capsoid/hab/README.md

# HAB - High Altitude Ballon Project

The repository contains documentation on building and launching high altitude balloon.

## Content

- **general-ideas.md** - the file lists general ideas and directions on the project;
- **flight-model** - equations and calculations on balloon motion.
