capsoid/hab/general-ideas.md

# General Ideas

Following items need to be worked out:
- **flight-train** - the balloon itself, helium (storage and filling systems), recovery system, cord and payload;
- **payload** - payload content, design and functionality;
- **launch** - procedure, conditions, date and legal considerations.

## Balloons
- **14"** - [RR-14P/XX](http://shar.by/catalog/rr-14p-04-pastel-oranzhevyj) with diameter 0.36m and weight 0.0043kg (0.16BYR);
- **27"** - [G220/XX](http://shar.by/catalog/g220-14-pastel-chyornyj) with diameter 0.70m and weight 0.01955kg (2.00BYR);
- **45"** - [P350/XX](http://shar.by/catalog/p-350-002-olimpijskij-pastel-ekstra) with diameter 1.15m and weight 0.0445kg (4.00BYR).

## Helium
- **tank** - [0.01m<sup>3</sup>](http://shar.by/catalog/ballon-gelievyj-10l) able to store about 1.4m<sup>3</sup> of helium at STP (150BYR);
- **gas** - [0.01m<sup>3</sup>](http://shar.by/catalog/gelij-10-litrov) 99.8% about 1.4m<sup>3</sup> at STP (140BYR);
- **pressure regulator** - [БГО-50-4ВШ](https://shop.oliver.by/cat3/gazovaya-svarka/kopiya-reduktor-aczetilenovyij-s-manometrom-kitaj.html) (65.00BYR);
- **stand** - [transportable](http://donballon.by/product/telezhka-podstavka-dlya-ballona-10l/) for 0.01m<sup>3</sup> tank (162,16BYR) also there is [cheaper option](http://donballon.by/product/podstavka-pod-ballon-10-litrov/) but it's absent for now;
- **high-pressure hose** - later we may need the hose to fill big balloons (can be ordered for right connectors and length).

## Pressure-size Balloon Experiment
The dependency of balloon diameter on pressure difference is required to complete the set of equations for balloon dynamic. The experiment requires pressure sensor. The existing Bosh sensor with [the instructions](http://faradaysclub.com/?p=1325) can be easily used. Additionally, an air hose for aquarium like [this one](https://garfield.by/catalog/akvariumistika/aeratsiya/komplektuyushchie/boyu-rt-shlang.html).

## Payload Cooling Experiment
The payload needs to stay on-line at temperatures -50 - -60 &deg;C. To achieve the temperature range on the ground we can use dry ice from [Bar Portal](http://shop.barportal.by/siropi-pyure-i-kokteylnie-komponenti/ice/dry-ice/).

## Smoke Test

Quick flight test for two balloons:
- size 0.37m lift 22g (calculated lift for 15 &deg;C and 101.325 kPa - 18.9g; vol 0.0265m<sup>3</sup>);
- size 0.455m lift 44g (calculated lift for 15 &deg;C and 101.325 kPa - 43.0g; vol 0.0493m<sup>3</sup>).

Karatsevich'es device test:

The device is represented by a piece of nichrome wire with resistance about 0.7 - 1&#x3a9;.
- power source of 3.5V and current 4.3A the device burns latex within 3 - 4s;
- batteries (2 AA) 3.1 - 3.2V (drops to 2.5V) and current 2.8A burns latex within similar interval.

## Other HAB Links
- HAB BOM: https://community.balloonchallenge.org/t/hab-supplies-list/677 (Radar Reflector is interesting)
- HAB electronics: https://www.sparkfun.com/tutorials/185 (1W 900MHz transmitter)
- HAB eqiupment enclosure and heater: https://www.sparkfun.com/tutorials/188
- HAB 29MHz 50mW transmitter (200miles distance) https://www.swharden.com/wp/2010-07-14-high-altitude-balloon-transmitter/
- HAB Flight Planner: http://astra-planner.soton.ac.uk/
- Flight Predictor: http://predict.habhub.org
