capsoid/hab/hardware/Friis formula.xlsx

 | Friis Formula
TX power | Pt | 0.01 | W
RX antenna gain | Gr | 1 | times
TX antenna gain | Gt | 5 | times
speed of light | c | 299972458 | m/s
Frequency | f | 434000000 | Hz
Distance | d | 38900 | m
RX power | Pr | 9.996776795e-14 | W | -100.0014 | dBm
 | Antenna gain "times-to-dBi"
Antenna gain: | G | 5 | times | 6.989700043 | dBi
 | Power "Watts-to-dBm"
Power | P | 9.9968e-14 | W | -100.00139 | dBm
