capsoid/hab/flight-model/model.pdf

# Flight Model

Vasili V

November 22, 2018

## 1 Lift

The buoyant force on a balloon of diameter d with density of content ρin and environmental density ρout:

Fb = (ρout − ρin)g

πd³
6
, | (1)

where content is Helium with density (at STP):

ρin = 0.1786 [kg m⁻³
]. | (2)

The environment is standard atmosphere taken from [1] at zero altitude:

ρout = 1.225 [kg m⁻³
]. | (3)

under following conditions:

p = 1.013 25 × 10⁵

[kg m⁻³
].
T = 288.15 | [K].

(4)

Under the conditions Helium density is:

ρin = 0.1786 ·

1.013 25 × 10⁵
1 × 10⁵

·

273.15
288.15

= 0.1715 [kg m⁻³
]. | (5)

Let’s simplify equation (1): Fb = k0d

3
, | (6)

where k0 is:

k0 =

π
6
- 9.81 · (1.225 − 0.1715) = 5.411. [N m⁻³
] | (7)

For example balloons with diameters 0.36, 0.70 and 1.15 m get following lifts:

Fs = 5.411 · 0.36³ = 0.2525[N] = 25.74[gf];

Fm = 5.411 · 0.70³ = 1.856[N] = 189.3[gf];

Fb = 5.411 · 1.15³ = 8.230[N] = 839.2[gf].

(8)

1

These balloons have following volumes:

Vs = 24.43 [L];
Vm = 179.6 [L];
Vb = 796.3 [L],

(9)

which is approximately 1
57 ,

1/7 and 2
3

of 10 L tank.

## References

[1] NOAA, NASA, USAF, US. Standard Atmosphere, 1976

2
