capsoid/hab/experiments/size-pressure/README.md

# Size-Pressure Experiment

The directory contains data on size-pressure dependency measurements. The size and pressure measured both for balloon inflation and deflation. 18" and 36" balloons have been used in the experiment.

# Schema

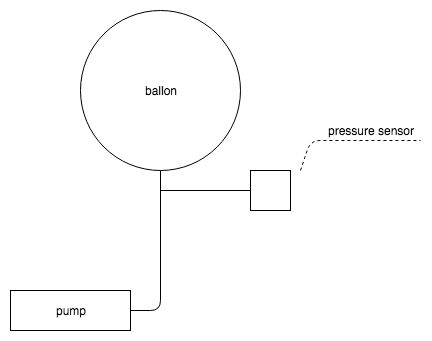
[picture p1: experiments/size-pressure/s-p.png]
Size-Pressure Experiment Schema


BMP180 has been used as pressure sensor.
=======
# Size-Pressure Experiment

The directory contains data on size-pressure dependency measurements. The size and pressure measured both for balloon inflation and deflation. A 18" balloon has been used in the experiment.

# Schema

Size-Pressure Experiment Schema

BMP180 has been used as pressure sensor.
