capsoid/hab/hardware/stratospheric_balloon/stratospheric_balloon.pdf

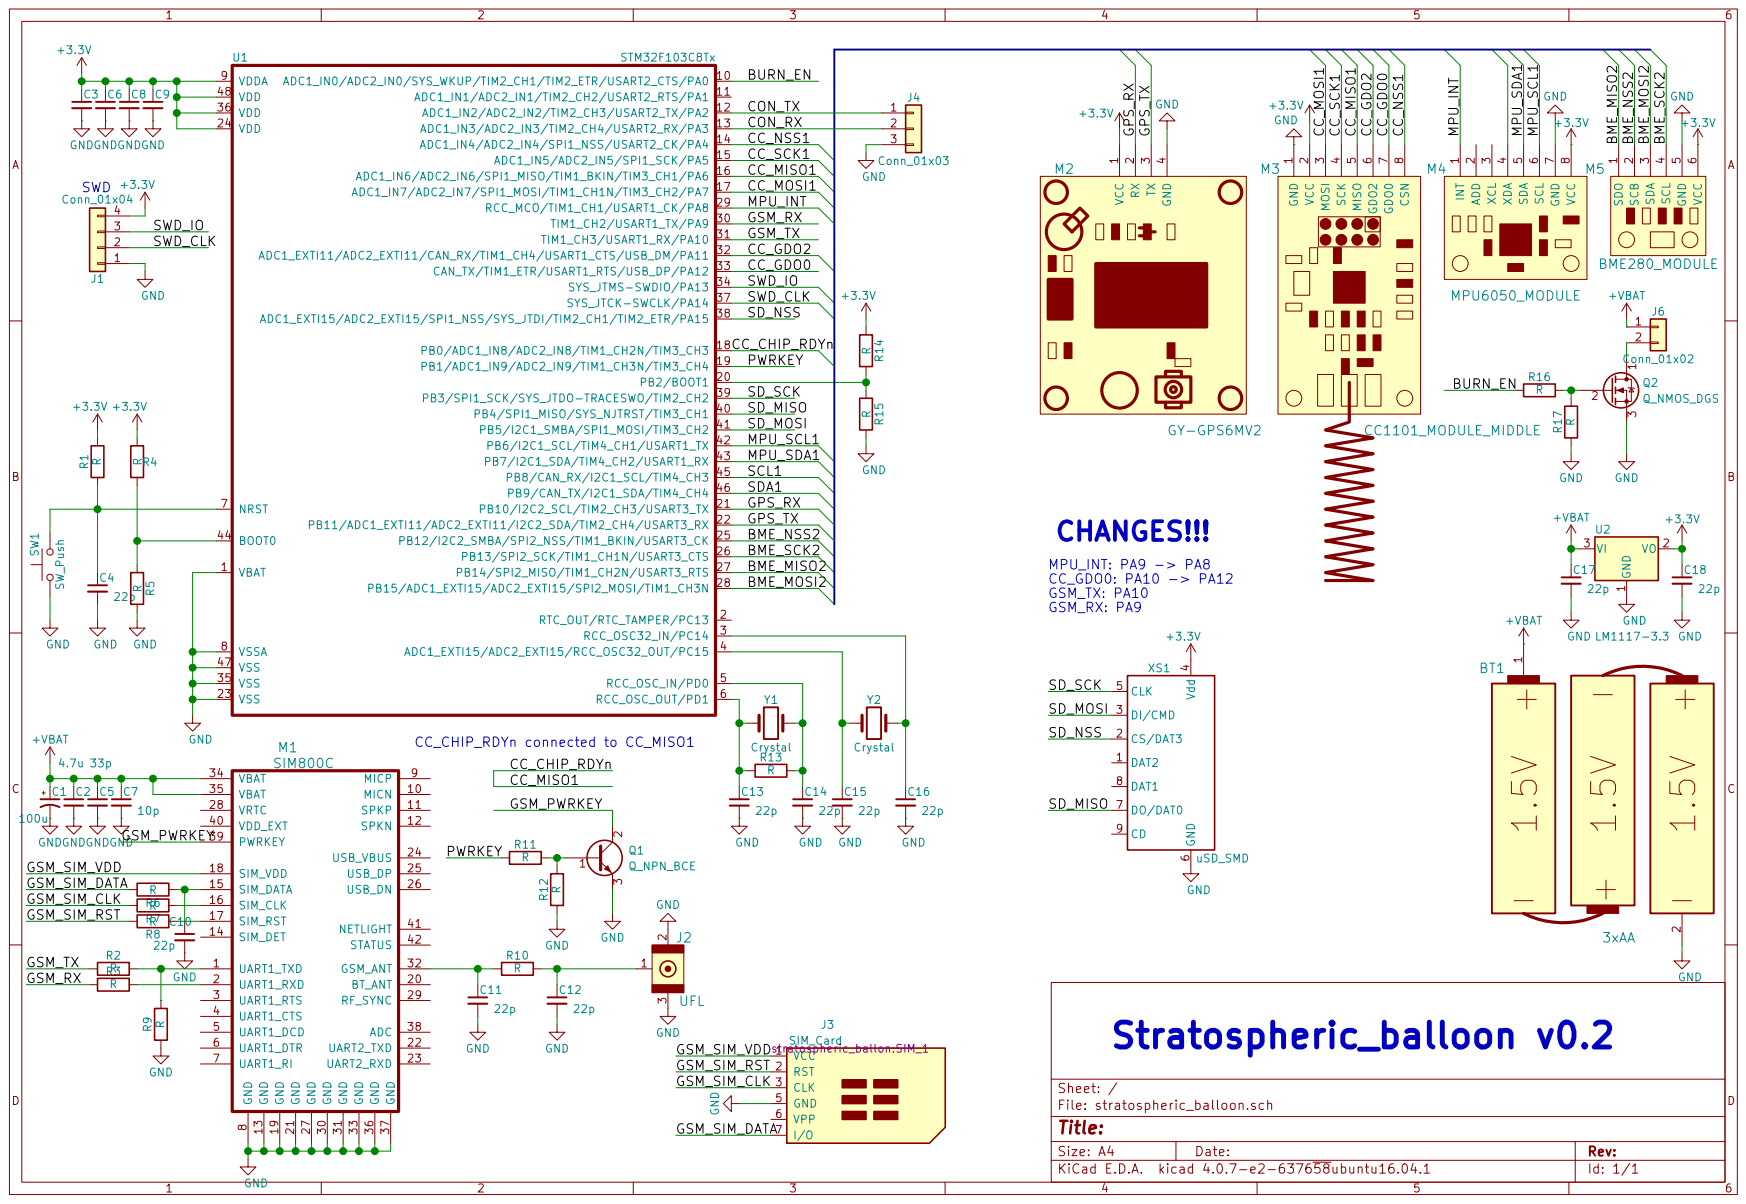
[picture p2: page 1]
