capsoid/hab/hardware/stratospheric_balloon/stratospheric_balloon.kicad_pcb

## KiCad design hardware/stratospheric_balloon/stratospheric_balloon.kicad_pcb (2019-07-24)

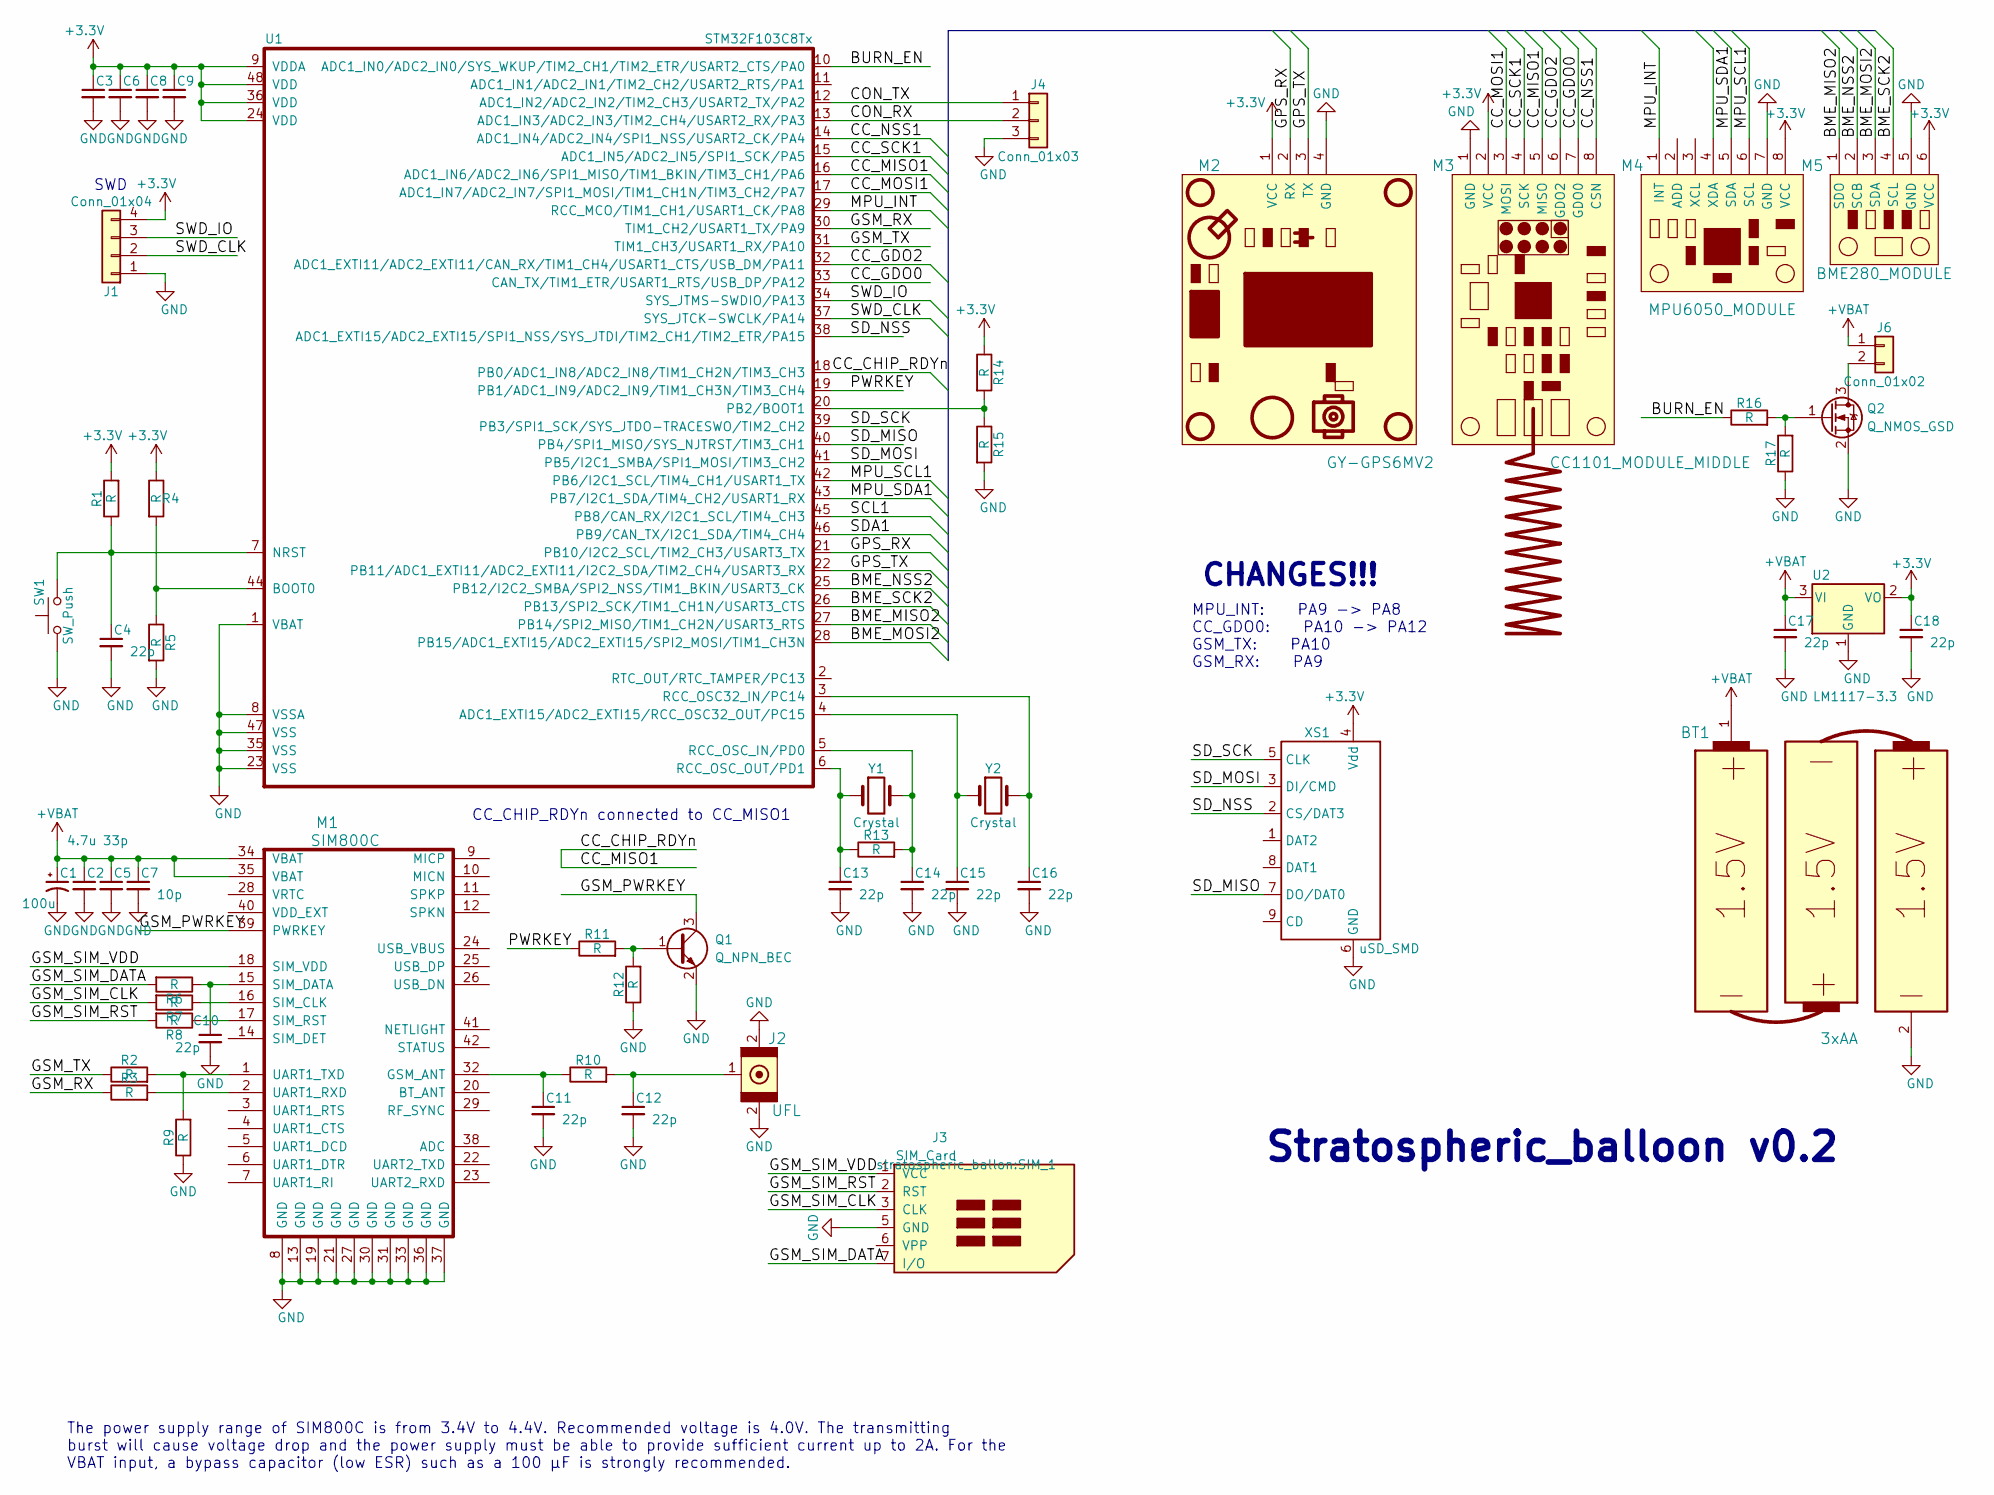
[picture p3: schematic stratospheric_balloon.sch]

Parts:
BT1: 3xAA
C1: 100u; CP_Tantalum_Case-C_EIA-6032-28_Reflow
C2: 4.7u; C_0603
C3, C6, C8, C9: C_0603
C4, C10, C11, C12, C13, C14, C15, C16, C17, C18: 22p; C_0603
C5: 33p; C_0603
C7: 10p; C_0603
J1: Conn_01x04; PinHeader_1x04_P2.54mm_Vertical
J2: UFL; U.FL_Molex_MCRF_73412-0110_Vertical
J3: SIM_Card; SIM_1
J4: Conn_01x03; PinHeader_1x03_P2.54mm_Vertical
J6: Conn_01x02; TerminalBlock_bornier-2_P5.08mm
M1: SIM800C; SIMCom_SIM800C
M2: GY-GPS6MV2; GY-GPS6MV2_MODULE
M3: CC1101_MODULE_MIDDLE
M4: MPU6050_MODULE
M5: BME280_MODULE
Q1: Q_NPN_BEC; SOT-23
Q2: Q_NMOS_GSD; SOT-23
R1, R2, R3, R4, R5, R6, R7, R8, R9, R10, R11, R12, R13, R14, R15, R16, R17: R; R_0603
SW1: SW_Push
U1: STM32F103C8Tx; LQFP-48_7x7mm_Pitch0.5mm
U2: LM1117-3.3; SOT-223
XS1: uSD_SMD; Conn_uSDcard
Y1: Crystal; Crystal_HC49-4H_Vertical
Y2: Crystal; Crystal_Round_d2.0mm_Vertical

Connections:
+3V3: C3.1, C6.1, C8.1, C9.1, C18.1, J1.4, M2.1 (VCC), M3.2 (VCC), M4.8 (VCC), M5.6 (VCC), R1.2, R4.1, R14.1, U1.9 (VDDA), U1.24 (VDD), U1.36 (VDD), U1.48 (VDD), U2.2 (VO), XS1.4 (Vdd)
/BME_MISO2: M5.1 (SDO), U1.27 (PB14/SPI2_MISO/TIM1_CH2N/USART3_RTS)
/BME_MOSI2: M5.3 (SDA), U1.28 (PB15/ADC1_EXTI15/ADC2_EXTI15/SPI2_MOSI/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)
/BME_NSS2: M5.2 (SCB), U1.25 (PB12/I2C2_SMBA/SPI2_NSS/TIM1_BKIN/USART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)
/BME_SCK2: M5.4 (SCL), U1.26 (PB13/SPI2_SCK/TIM1_CH1N/USART3_CTS)
/BURN_EN: R16.1, U1.10 (ADC1_IN0/ADC2_IN0/SYS_WKUP/TIM2_CH1/TIM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)
/CC_CHIP_RDYn: M3.5 (MISO), U1.16 (ADC1_IN6/ADC2_IN6/SPI1_MISO/TIM1_BKIN/T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), U1.18 (PB0/ADC1_IN8/ADC2_IN8/TIM1_CH2N/TIM3_CH3)
/CC_GDO0: M3.7 (GDO0), U1.33 (CAN_TX/TIM1_ETR/USART1_RTS/USB_DP/PA12)
/CC_GDO2: M3.6 (GDO2), U1.32 (ADC1_EXTI11/ADC2_EXTI11/CAN_RX/TIM1_CH4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)
/CC_MOSI1: M3.3 (MOSI), U1.17 (ADC1_IN7/ADC2_IN7/SPI1_MOSI/TIM1_CH1N/T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)
/CC_NSS1: M3.8 (CSN), U1.14 (ADC1_IN4/ADC2_IN4/SPI1_NSS/USART2_CK/PA4)
/CC_SCK1: M3.4 (SCK), U1.15 (ADC1_IN5/ADC2_IN5/SPI1_SCK/PA5)
/CON_RX: J4.2, U1.13 (ADC1_IN3/ADC2_IN3/TIM2_CH4/USART2_RX/PA3)
/CON_TX: J4.1, U1.12 (ADC1_IN2/ADC2_IN2/TIM2_CH3/USART2_TX/PA2)
/GPS_RX: M2.2 (RX), U1.21 (PB10/I2C2_SCL/TIM2_CH3/USART3_TX)
/GPS_TX: M2.3 (TX), U1.22 (PB11/ADC1_EXTI11/ADC2_EXTI11/I2C2_SDA/T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)
/GSM_PWRKEY: M1.39 (PWRKEY), Q1.3 (C)
/GSM_RX: R3.1, U1.30 (TIM1_CH2/USART1_TX/PA9)
/GSM_SIM_CLK: J3.3 (CLK), R7.2
/GSM_SIM_DATA: J3.7 (I/O), R6.2
/GSM_SIM_RST: J3.2 (RST), R8.2
/GSM_SIM_VDD: J3.1 (VCC), M1.18 (SIM_VDD)
/GSM_TX: R2.1, U1.31 (TIM1_CH3/USART1_RX/PA10)
/MPU_INT: M4.1 (INT), U1.29 (RCC_MCO/TIM1_CH1/USART1_CK/PA8)
/MPU_SCL1: M4.6 (SCL), U1.42 (PB6/I2C1_SCL/TIM4_CH1/USART1_TX)
/MPU_SDA1: M4.5 (SDA), U1.43 (PB7/I2C1_SDA/TIM4_CH2/USART1_RX)
/PWRKEY: R11.1, U1.19 (PB1/ADC1_IN9/ADC2_IN9/TIM1_CH3N/TIM3_CH4)
/SD_MISO: U1.40 (PB4/SPI1_MISO/SYS_NJTRST/TIM3_CH1), XS1.7 (DO/DAT0)
/SD_MOSI: U1.41 (PB5/I2C1_SMBA/SPI1_MOSI/TIM3_CH2), XS1.3 (DI/CMD)
/SD_NSS: U1.38 (ADC1_EXTI15/ADC2_EXTI15/SPI1_NSS/SYS_JT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), XS1.2 (CS/DAT3)
/SD_SCK: U1.39 (PB3/SPI1_SCK/SYS_JTDO-TRACESWO/TIM2_CH2), XS1.5 (CLK)
/SWD_CLK: J1.2, U1.37 (SYS_JTCK-SWCLK/PA14)
/SWD_IO: J1.3, U1.34 (SYS_JTMS-SWDIO/PA13)
GND: BT1.2, C1.2, C2.2, C3.2, C4.2, C5.2, C6.2, C7.2, C8.2, C9.2, C10.2, C11.2, C12.2, C13.2, C14.2, C15.2, C16.2, C17.2, C18.2, J1.1, J2.2, J3.5 (GND), J4.3, M1.8 (GND), M1.13 (GND), M1.19 (GND), M1.21 (GND), M1.27 (GND), M1.30 (GND), M1.31 (GND), M1.33 (GND), M1.36 (GND), M1.37 (GND), M2.4 (GND), M3.1 (GND), M4.7 (GND), M5.5 (GND), Q1.2 (E), Q2.2 (S), R5.2, R9.1, R12.1, R15.2, R17.1, SW1.1, U1.1 (VBAT), U1.8 (VSSA), U1.23 (VSS), U1.35 (VSS), U1.47 (VSS), U2.1 (GND), XS1.6 (GND)
unnamed: C4.1, R1.1, SW1.2, U1.7 (NRST)
unnamed: C10.1, M1.15 (SIM_DATA), R6.1
unnamed: C11.1, M1.32 (GSM_ANT), R10.1
unnamed: C12.1, J2.1, R10.2
unnamed: C13.1, R13.1, U1.6 (RCC_OSC_OUT/PD1), Y1.1
unnamed: C14.1, R13.2, U1.5 (RCC_OSC_IN/PD0), Y1.2
unnamed: C15.1, U1.4 (ADC1_EXTI15/ADC2_EXTI15/RCC_OSC32_OUT/P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), Y2.1
unnamed: C16.1, U1.3 (RCC_OSC32_IN/PC14), Y2.2
unnamed: J6.2, Q2.3 (D)
unnamed: M1.1 (UART1_TXD), R2.2, R9.2
unnamed: M1.2 (UART1_RXD), R3.2
unnamed: M1.16 (SIM_CLK), R7.1
unnamed: M1.17 (SIM_RST), R8.1
unnamed: Q1.1 (B), R11.2, R12.2
unnamed: Q2.1 (G), R16.2, R17.2
unnamed: R4.2, R5.1, U1.44 (BOOT0)
unnamed: R14.2, R15.1, U1.20 (PB2/BOOT1)
VBAT: BT1.1, C1.1, C2.1, C5.1, C7.1, C17.1, J6.1, M1.34 (VBAT), M1.35 (VBAT), U2.3 (VI)

Notes on the sheet:
Stratospheric_balloon v0.2
CC_CHIP_RDYn connected to CC_MISO1
The power supply range of SIM800C is from 3.4V to 4.4V. Recommended voltage is 4.0V. The transmitting burst will cause voltage drop and the power supply must be able to provide sufficient current up to 2A. For the VBAT input, a bypass capacitor (low ESR) such as a 100 µF is strongly recommended.
SWD
MPU_INT: PA9 -> PA8 CC_GDO0: PA10 -> PA12 GSM_TX: PA10 GSM_RX: PA9
CHANGES!!!

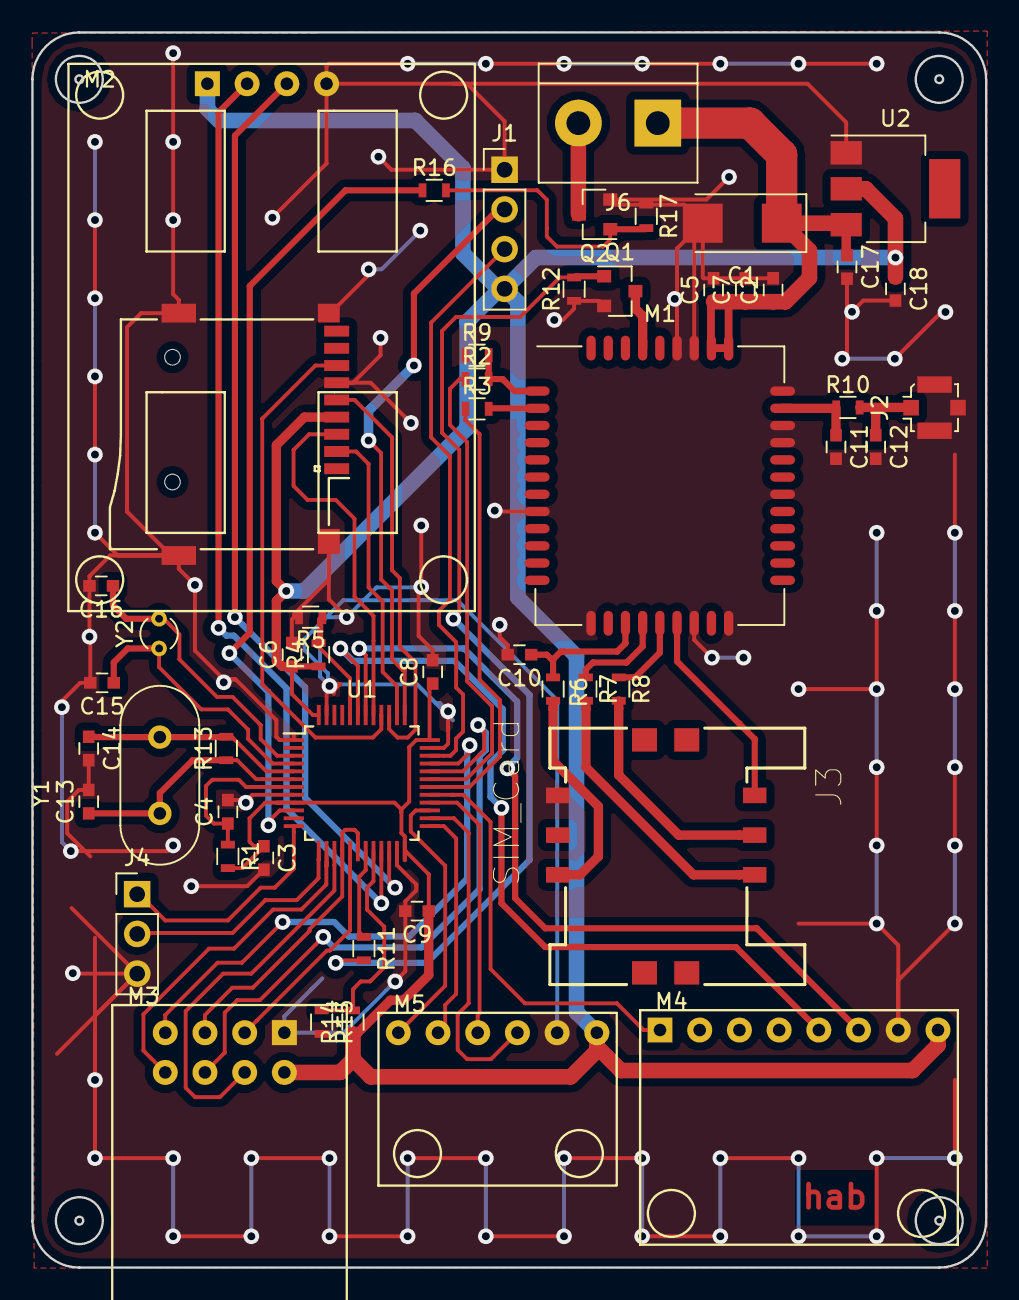
[picture p4: board stratospheric_balloon.kicad_pcb from above]

Board: 2 copper layers, 61.0 x 79.0 mm, 52 parts (0 on the bottom side), 52 nets.
