capsoid/hab/(commit log)

2018-11-22 Add note on pressure-size experiment
2018-12-03 Add zephyr project for stm32 blue pill
2018-12-04 Schematic added
    [stratospheric_balloon.kicad_pcb, stratospheric_balloon.sch]
2018-12-04 Add Friis formula xls
    [Friis formula.xlsx]
2018-12-04 A bit more of SPI
2018-12-09 Add cc1101 code skeleton, not tested, not working
    [cc1101.c, main.c]
2018-12-09 Added first data on size-pressure experiment
    [s-p.csv]
2018-12-09 Add size-pressure experiment schema; Round volume data on the graph
2018-12-09 Scale down size-pressure experiment schema
2018-12-10 Schematic diagram was corrected
    [stratospheric_balloon.sch]
2018-12-11 Account for CHIP_RDYn pin
2018-12-12 Reconfigure to see threads info from shell
2018-12-13 Adjust cc1101 pin connections according to schematics
2018-12-14 Fix spi data format
    [cc1101.c]
2018-12-16 Add results of size-pressure experiment for 36"
    [s-p.csv]
2018-12-19 Add mpu6050 manual reset
    [main.c]
2018-12-20 Fix mpu6050 values displaying
    [main.c]
2018-12-20 Add cc1101 driver implementation from PR
2018-12-20 Crunch in cc1101 driver
2018-12-21 Add DEVICE_INIT and gpios conf
2018-12-21 Fix cc1101 initalization
    Still crashes when RX thread is spawned ...
    [cc1101.c, ieee802154_cc1101.c, ieee802154_cc1101.h, main.c]
2018-12-22 Setup channel and tx power on startup
2018-12-28 Fix gpio interrupts conf
    [ieee802154_cc1101.c, ieee802154_cc1101_rf.h]
2019-03-28 Add mcu and modem schematic components
2019-04-04 Add some components for GSM and MCU
    [stratospheric_balloon.sch]
2019-04-07 Put all components on A4. Do connectians.
    [stratospheric_balloon.sch]
2019-04-07 Add SIM and microsd slots
    [stratospheric_balloon.sch]
2019-04-10 Add footprints for GPS, GSM, BME, MPU
2019-04-20 Add some footprints
2019-04-22 Assign some footprints to sch elements
    [stratospheric_balloon.kicad_pcb, stratospheric_balloon.sch]
2019-04-26 Fix mistakes with footprints. Do layout
    [stratospheric_balloon.kicad_pcb, stratospheric_balloon.sch]
2019-05-01 Add some changes in layout
    [stratospheric_balloon.kicad_pcb]
2019-07-12 Change vias. Add power planes
    [stratospheric_balloon.kicad_pcb]
2019-07-24 Add vias
    [stratospheric_balloon.kicad_pcb]
2019-07-24 Add origin. Add sizes.
    [stratospheric_balloon.kicad_pcb]
2019-08-04 Add some values
    [stratospheric_balloon.sch]
2019-08-13 Add layout
    [stratospheric_balloon.kicad_pcb]
2020-02-09 Change config to use UART_2 as console output, remap cc1101 output to resole conflict with UART_2
2020-02-10 Create stub for bme280 device in dts
2020-02-14 Change MPU interruption pin and i2c clock speed
2020-02-28 Create basic device for GPS
2020-03-04 Add ring buffer for reading gps via interrupts
2020-07-09 Replace ringbuf with simple array
    [neo_6m.c, neo_6m.h]
